aviralverma-8877/raspberrypi-pico-gamepad/README.md

# raspberrypi-pico-gamepad
Raspberry Pi Pico based Gamepad
