aviralverma-8877/raspberrypi-pico-gamepad/3D Prints/Pico Gamepad Bottom.stl

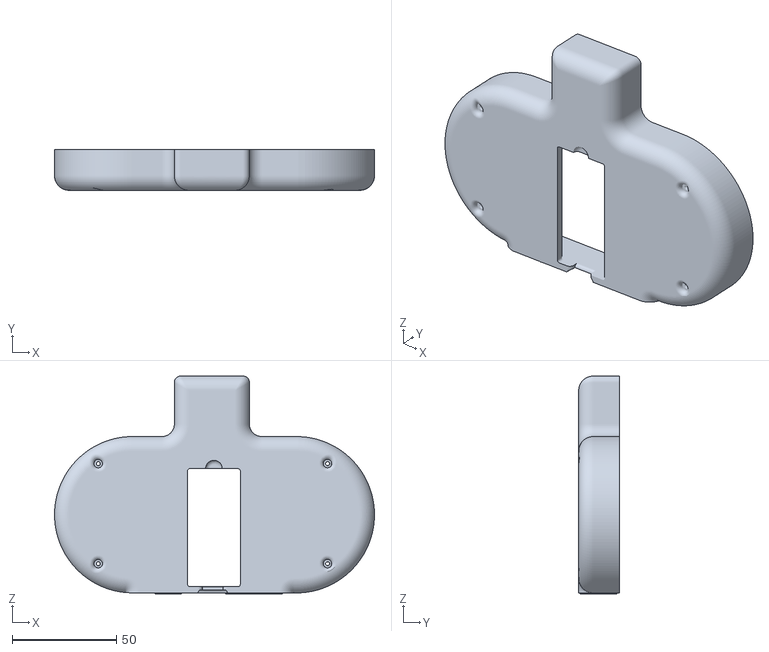
[picture p1: CAD file, 2021-06-02]
3D Prints/Pico Gamepad Bottom.stl
153.5 x 19.5 x 104.5
