aviralverma-8877/raspberrypi-pico-gamepad/PCB_design/Pico Gamepad.brd

## EAGLE design PCB_design/Pico Gamepad.brd (2021-04-26)

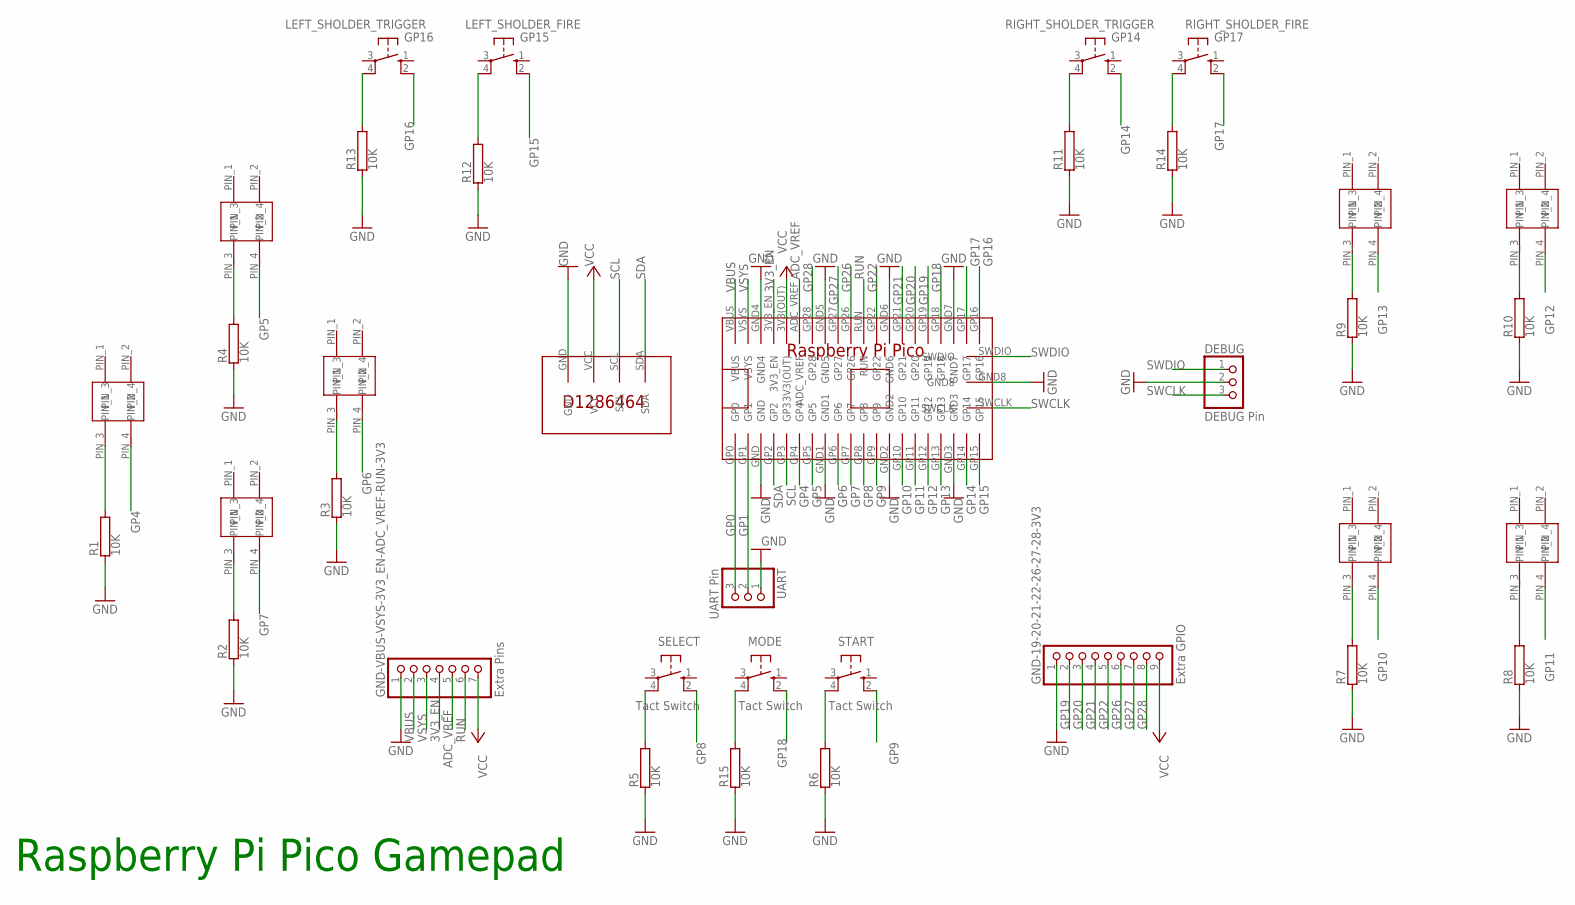
[picture p2: schematic Pico Gamepad.sch]

Parts:
A: GAMEPAD_BTN
B: GAMEPAD_BTN
DEBUG: DEBUG Pin; 1X03
DOWN: GAMEPAD_BTN
GND-19-20-21-22-26-27-28-3V3: Extra GPIO; 1X09
GND-VBUS-VSYS-3V3_EN-ADC_VREF-RUN-3V3: Extra Pins; 1X07
LEFT: GAMEPAD_BTN
LEFT_SHOLDER_FIRE: GP15; B3F-10XX
LEFT_SHOLDER_TRIGGER: GP16; B3F-10XX
MODE: Tact Switch; B3F-10XX
R1, R2, R3, R4, R5, R6, R7, R8, R9, R10, R11, R12, R13, R14, R15: 10K; RS1/8
RIGHT: GAMEPAD_BTN
RIGHT_SHOLDER_FIRE: GP17; B3F-10XX
RIGHT_SHOLDER_TRIGGER: GP14; B3F-10XX
SELECT: Tact Switch; B3F-10XX
START: Tact Switch; B3F-10XX
U$1: RASPBERRYPIPICO
U$2: OLED_DISPLAY
UART: UART Pin; 1X03
UP: GAMEPAD_BTN
X: GAMEPAD_BTN
Y: GAMEPAD_BTN

Connections:
3V3_EN: GND-VBUS-VSYS-3V3_EN-ADC_VREF-RUN-3V3.4, U$1.3V3_EN
ADC_VREF: GND-VBUS-VSYS-3V3_EN-ADC_VREF-RUN-3V3.5, U$1.ADC_VREF
GND: DEBUG.2, GND-19-20-21-22-26-27-28-3V3.1, GND-VBUS-VSYS-3V3_EN-ADC_VREF-RUN-3V3.1, R1.1, R2.1, R3.1, R4.1, R5.1, R6.1, R7.1, R8.1, R9.1, R10.1, R11.1, R12.1, R13.1, R14.1, R15.1, U$1.GND, U$1.GND1, U$1.GND2, U$1.GND3, U$1.GND4, U$1.GND5, U$1.GND6, U$1.GND7, U$1.GND8, U$2.GND, UART.1
GP0: U$1.GP0, UART.3
GP1: U$1.GP1, UART.2
GP4: LEFT.PIN_4, U$1.GP4
GP5: U$1.GP5, UP.PIN_4
GP6: RIGHT.PIN_4, U$1.GP6
GP7: DOWN.PIN_4, U$1.GP7
GP8: SELECT.2 (S1), U$1.GP8
GP9: START.2 (S1), U$1.GP9
GP10: A.PIN_4, U$1.GP10
GP11: B.PIN_4, U$1.GP11
GP12: U$1.GP12, Y.PIN_4
GP13: U$1.GP13, X.PIN_4
GP14: RIGHT_SHOLDER_TRIGGER.2 (S1), U$1.GP14
GP15: LEFT_SHOLDER_FIRE.2 (S1), U$1.GP15
GP16: LEFT_SHOLDER_TRIGGER.2 (S1), U$1.GP16
GP17: RIGHT_SHOLDER_FIRE.2 (S1), U$1.GP17
GP18: MODE.2 (S1), U$1.GP18
GP19: GND-19-20-21-22-26-27-28-3V3.2, U$1.GP19
GP20: GND-19-20-21-22-26-27-28-3V3.3, U$1.GP20
GP21: GND-19-20-21-22-26-27-28-3V3.4, U$1.GP21
GP22: GND-19-20-21-22-26-27-28-3V3.5, U$1.GP22
GP26: GND-19-20-21-22-26-27-28-3V3.6, U$1.GP26
GP27: GND-19-20-21-22-26-27-28-3V3.7, U$1.GP27
GP28: GND-19-20-21-22-26-27-28-3V3.8, U$1.GP28
unnamed: R9.2, X.PIN_3
unnamed: R10.2, Y.PIN_3
unnamed: R11.2, RIGHT_SHOLDER_TRIGGER.4 (P1)
unnamed: LEFT_SHOLDER_FIRE.4 (P1), R12.2
unnamed: R4.2, UP.PIN_3
unnamed: LEFT.PIN_3, R1.2
unnamed: DOWN.PIN_3, R2.2
unnamed: R3.2, RIGHT.PIN_3
unnamed: MODE.4 (P1), R15.2
unnamed: R5.2, SELECT.4 (P1)
unnamed: R6.2, START.4 (P1)
unnamed: A.PIN_3, R7.2
unnamed: B.PIN_3, R8.2
unnamed: LEFT_SHOLDER_TRIGGER.4 (P1), R13.2
unnamed: R14.2, RIGHT_SHOLDER_FIRE.4 (P1)
RUN: GND-VBUS-VSYS-3V3_EN-ADC_VREF-RUN-3V3.6, U$1.RUN
SCL: U$1.GP3, U$2.SCL
SDA: U$1.GP2, U$2.SDA
SWCLK: DEBUG.3, U$1.SWCLK
SWDIO: DEBUG.1, U$1.SWDIO
VBUS: GND-VBUS-VSYS-3V3_EN-ADC_VREF-RUN-3V3.2, U$1.VBUS
VCC: GND-19-20-21-22-26-27-28-3V3.9, GND-VBUS-VSYS-3V3_EN-ADC_VREF-RUN-3V3.7, U$1.3V3(OUT), U$2.VCC
VSYS: GND-VBUS-VSYS-3V3_EN-ADC_VREF-RUN-3V3.3, U$1.VSYS

Notes on the sheet:
Raspberry Pi Pico Gamepad

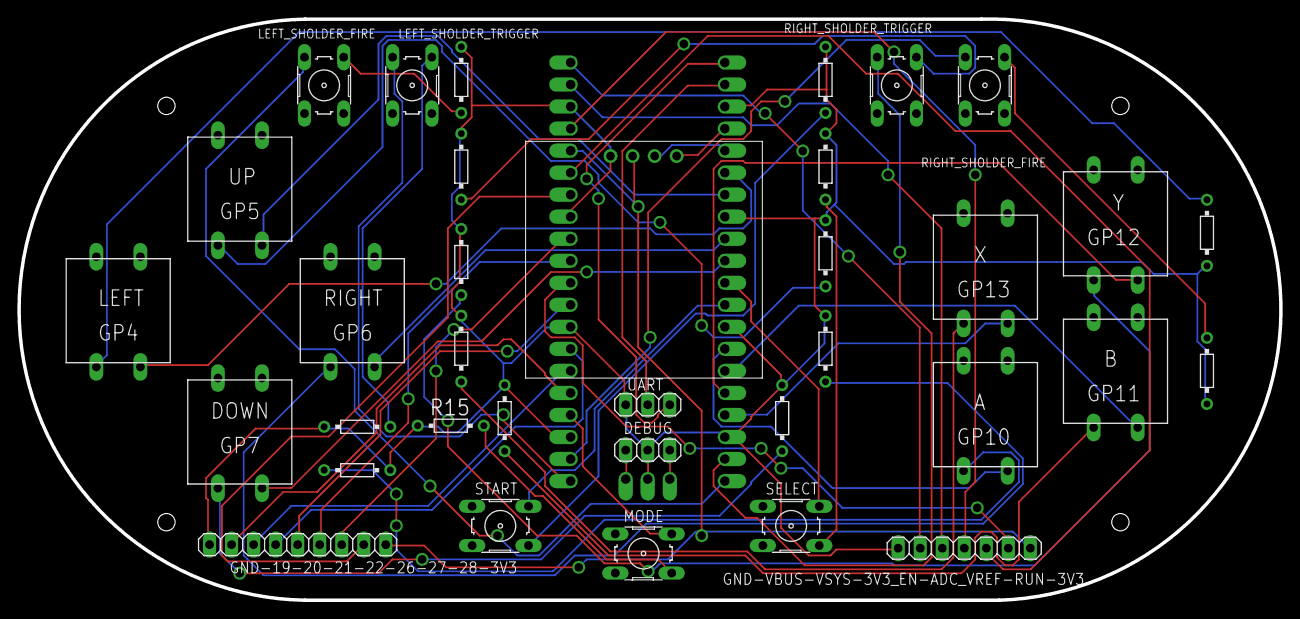
[picture p3: board Pico Gamepad.brd from above]

Board: 2 copper layers, 145.5 x 67.0 mm, 36 parts (1 on the bottom side), 50 nets.
