aviralverma-8877/raspberrypi-pico-gamepad/(commit log)

2021-04-26 PCB Design Added
    [Pico Gamepad.brd, Pico Gamepad.sch]
2021-06-02 3D Print File added
    [Pico Gamepad Bottom.stl]
2021-11-25 Circuit Python added
